YairOlvera130703/FSK-ROBOTIC-ARM-CONTROL/SIGNALS_DIAGRAM.pdf

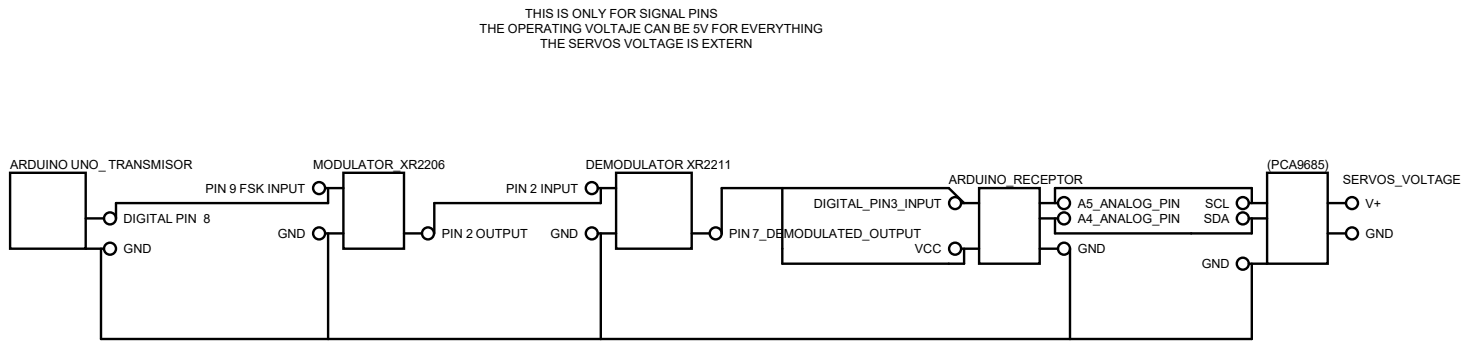
[picture p15: figure]
GND; DIGITAL PIN 8; ARDUINO UNO_ TRANSMISOR; MODULATOR_XR2206; PIN 9 FSK INPUT; DEMODULATOR XR2211; PIN 2 OUTPUT; DIGITAL_PIN3_INPUT; PIN 2 INPUT; PIN 7_DEMODULATED_OUTPUT; A4_ANALOG_PIN; A5_ANALOG_PIN; ARDUINO_RECEPTOR; SCL; VCC; SDA; (PCA9685); SERVOS_VOLTAGE; THIS IS ONLY FOR SIGNAL PINS; THE SERVOS VOLTAGE IS EXTERN

THE OPERATING VOLTAJE CAN BE 5V FOR EVERYTHING
